ErolDude/ETF-LoRaGateway-Thesis/seal_of_approval.bmp

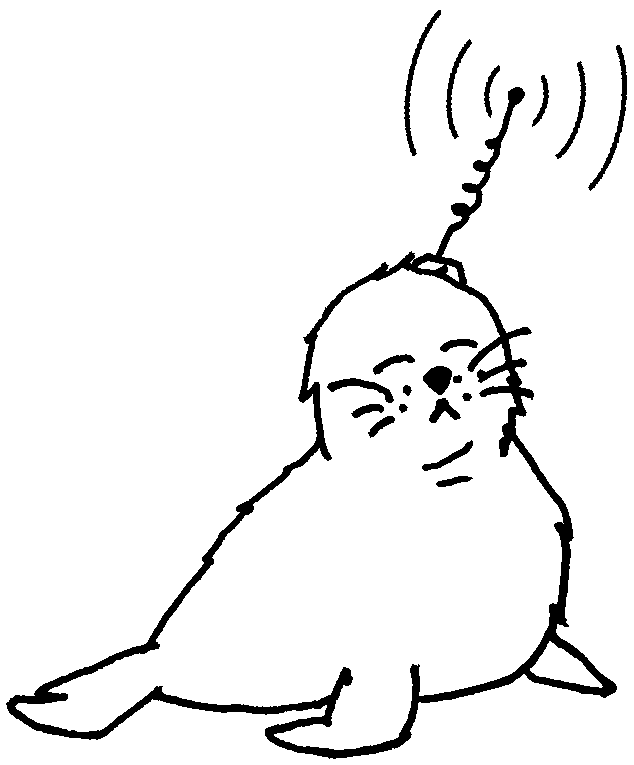
seal_of_approval.bmp
