ErolDude/ETF-LoRaGateway-Thesis/LoRa Gateway ESP32 - Final.brd

## EAGLE design LoRa Gateway ESP32 - Final.brd (2021-06-04)

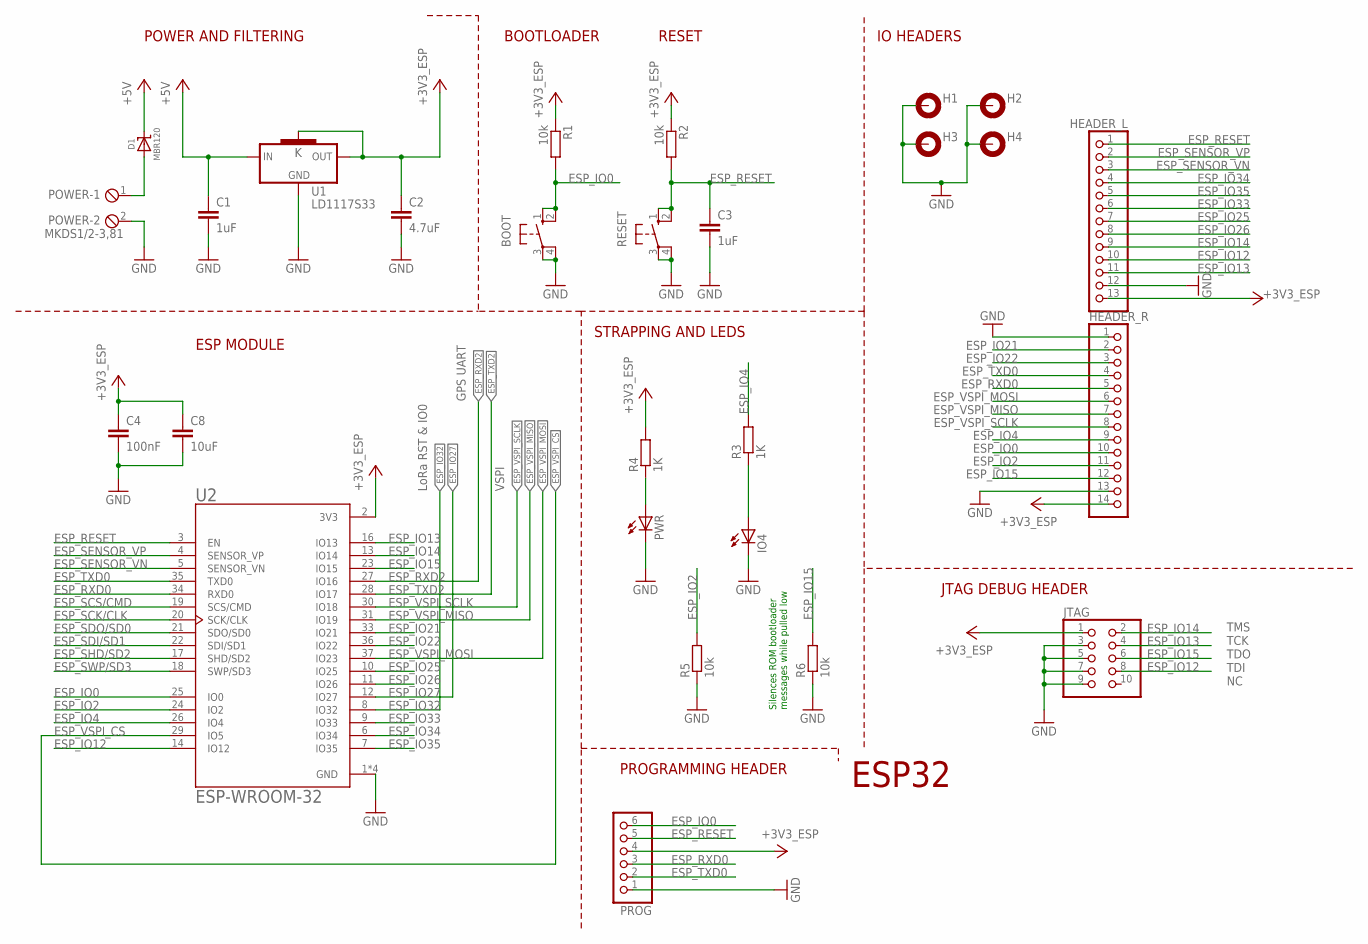
[picture p24: schematic LoRa Gateway ESP32 - Final.sch, sheet 1, ESP]

Parts:
BOOT: 10-XX; B3F-10XX
C1, C3: 1uF; C0805K
C2: 4.7uF; C0805K
C4: 100nF; C0805K
C8: 10uF; C0805K
D1: MBR120; SOD-123
H1, H2, H3, H4: MOUNT-PAD-ROUND3.2; 3,2-PAD
HEADER_L: PINHD-1X13; 1X13
HEADER_R: PINHD-1X14; 1X14
IO4: LEDCHIP-LED0805; CHIP-LED0805
JTAG: PINHD-2X5; 2X05
POWER: MKDS1/2-3,81; 2POL381
PROG: PINHD-1X6; 1X06
PWR: LEDCHIP-LED0805; CHIP-LED0805
R1, R2, R5, R6: 10k; R0805
R3, R4: 1K; R0805
RESET: 10-XX; B3F-10XX
U1: LD1117S33; SOT223
U2: ESP-WROOM-32; MODULE_ESP-WROOM-32

Connections:
+3V3_ESP: C2.1, C4.1, C8.1, HEADER_L.13, HEADER_R.14, JTAG.1, PROG.4, R1.1, R2.1, R4.2, U1.2 (OUT), U1.4 (K), U2.2 (3V3); also elsewhere on the board
+5V: C1.1, D1.C, U1.3 (IN)
ESP_IO0: BOOT.1 (S), BOOT.2 (S1), HEADER_R.10, PROG.6, R1.2, U2.25 (IO0)
ESP_IO2: HEADER_R.11, R5.2, U2.24 (IO2)
ESP_IO4: HEADER_R.9, R3.2, U2.26 (IO4)
ESP_IO12: HEADER_L.10, JTAG.8, U2.14 (IO12)
ESP_IO13: HEADER_L.11, JTAG.4, U2.16 (IO13)
ESP_IO14: HEADER_L.9, JTAG.2, U2.13 (IO14)
ESP_IO15: HEADER_R.12, JTAG.6, R6.2, U2.23 (IO15)
ESP_IO21: HEADER_R.2, U2.33 (IO21)
ESP_IO22: HEADER_R.3, U2.36 (IO22)
ESP_IO25: HEADER_L.7, U2.10 (IO25)
ESP_IO26: HEADER_L.8, U2.11 (IO26)
ESP_IO27: U2.12 (IO27); also elsewhere on the board
ESP_IO32: U2.8 (IO32); also elsewhere on the board
ESP_IO33: HEADER_L.6, U2.9 (IO33)
ESP_IO34: HEADER_L.4, U2.6 (IO34)
ESP_IO35: HEADER_L.5, U2.7 (IO35)
ESP_RESET: C3.1, HEADER_L.1, PROG.5, R2.2, RESET.1 (S), RESET.2 (S1), U2.3 (EN)
ESP_RXD0: HEADER_R.5, PROG.3, U2.34 (RXD0)
ESP_RXD2: U2.27 (IO16); also elsewhere on the board
ESP_SCK/CLK: U2.20 (SCK/CLK)
ESP_SCS/CMD: U2.19 (SCS/CMD)
ESP_SDI/SD1: U2.22 (SDI/SD1)
ESP_SDO/SD0: U2.21 (SDO/SD0)
ESP_SENSOR_VN: HEADER_L.3, U2.5 (SENSOR_VN)
ESP_SENSOR_VP: HEADER_L.2, U2.4 (SENSOR_VP)
ESP_SHD/SD2: U2.17 (SHD/SD2)
ESP_SWP/SD3: U2.18 (SWP/SD3)
ESP_TXD0: HEADER_R.4, PROG.2, U2.35 (TXD0)
ESP_TXD2: U2.28 (IO17); also elsewhere on the board
ESP_VSPI_CS: U2.29 (IO5); also elsewhere on the board
ESP_VSPI_MISO: HEADER_R.7, U2.31 (IO19); also elsewhere on the board
ESP_VSPI_MOSI: HEADER_R.6, U2.37 (IO23); also elsewhere on the board
ESP_VSPI_SCLK: HEADER_R.8, U2.30 (IO18); also elsewhere on the board
GND: BOOT.3, BOOT.4 (P1), C1.2, C2.2, C3.2, C4.2, C8.2, H1.B3,2, H2.B3,2, H3.B3,2, H4.B3,2, HEADER_L.12, HEADER_R.1, HEADER_R.13, IO4.C, JTAG.3, JTAG.5, JTAG.7, JTAG.9, POWER.2, PROG.1, PWR.C, R5.1, R6.1, RESET.3, RESET.4 (P1), U1.1 (GND), U2.1 (GND), U2.1.1 (GND), U2.15 (GND), U2.38 (GND); also elsewhere on the board
unnamed: D1.A, POWER.1
unnamed: IO4.A, R3.1
unnamed: PWR.A, R4.1

Notes on the sheet:
Silences ROM bootloader messages while pulled low
GPS UART
VSPI
LoRa RST & IO0
ESP32
JTAG DEBUG HEADER
IO HEADERS
STRAPPING AND LEDS
ESP MODULE
POWER AND FILTERING
BOOTLOADER
RESET
PROGRAMMING HEADER
TMS TCK TDO TDI NC

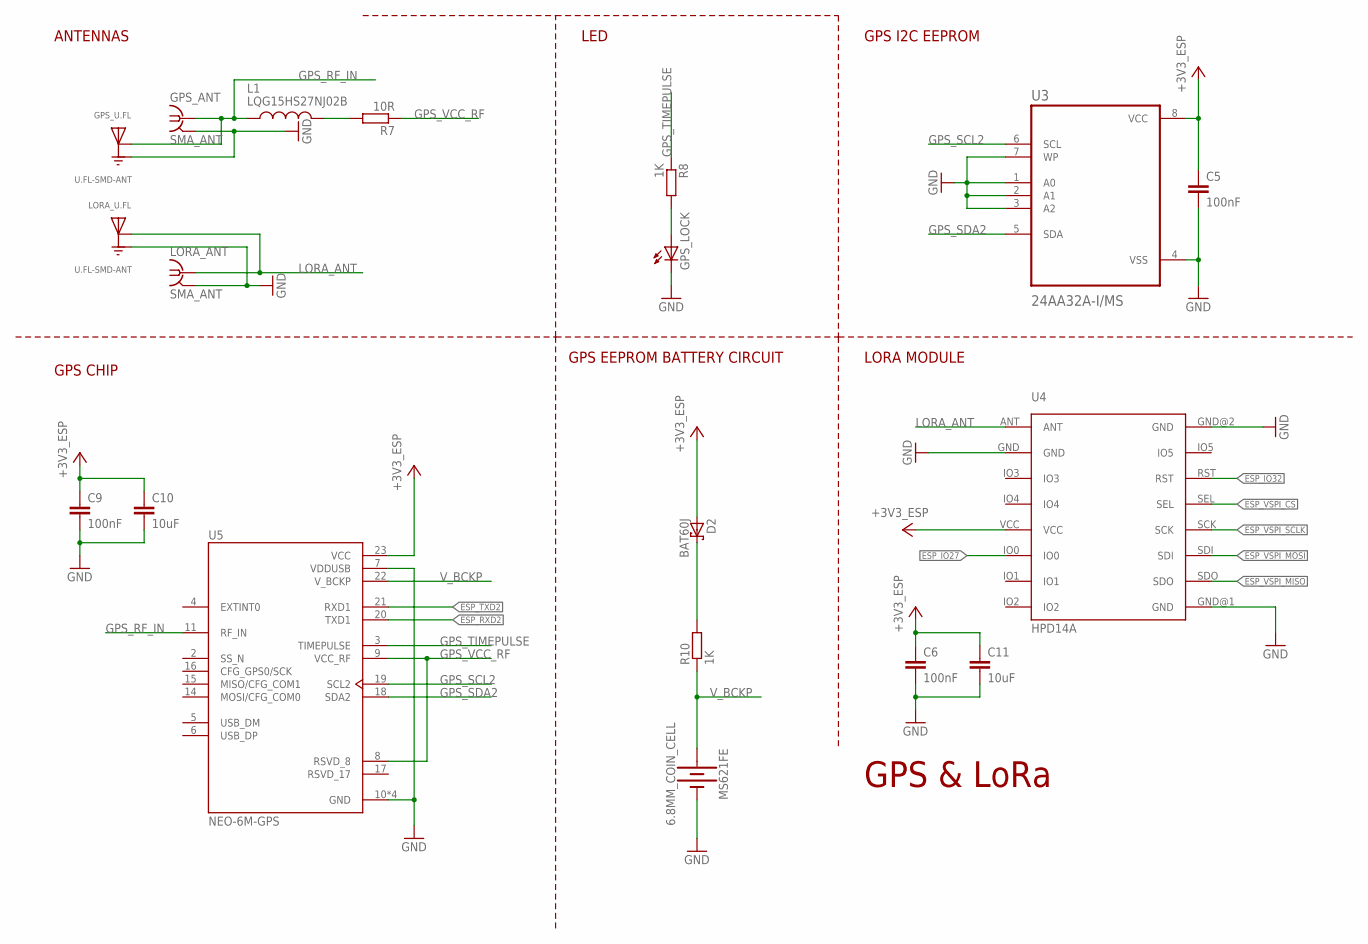
[picture p25: schematic LoRa Gateway ESP32 - Final.sch, sheet 2, Lora and GPS]

Parts:
C5, C6, C9: 100nF; C0805K
C10, C11: 10uF; C0805K
D2: BAT60J; SOD323_ST
GPS_ANT: SMA_ANT; BU-SMA-H
GPS_LOCK: LEDCHIP-LED0805; CHIP-LED0805
GPS_U.FL: U.FL-SMD-ANT; HRS_U.FL-R-SMT-1(10)
L1: LQG15HS27NJ02B; INDC1005X55N
LORA_ANT: SMA_ANT; BU-SMA-H
LORA_U.FL: U.FL-SMD-ANT; HRS_U.FL-R-SMT-1(10)
MS621FE: 6.8MM_COIN_CELL; BATTCON-6.8MM
R7: 10R; R0805
R8, R10: 1K; R0805
U3: 24AA32A-I/MS; SOP65P490X110-8N
U4: HPD14A
U5: NEO-6M-GPS; XCVR_NEO-6M-GPS

Connections:
+3V3_ESP: C5.1, C6.1, C9.1, C10.1, C11.1, D2.A, U3.8 (VCC), U4.VCC, U5.23 (VCC); also elsewhere on the board
ESP_IO27: U4.IO0; also elsewhere on the board
ESP_IO32: U4.RST; also elsewhere on the board
ESP_RXD2: U5.20 (TXD1); also elsewhere on the board
ESP_TXD2: U5.21 (RXD1); also elsewhere on the board
ESP_VSPI_CS: U4.SEL; also elsewhere on the board
ESP_VSPI_MISO: U4.SDO; also elsewhere on the board
ESP_VSPI_MOSI: U4.SDI; also elsewhere on the board
ESP_VSPI_SCLK: U4.SCK; also elsewhere on the board
GND: C5.2, C6.2, C9.2, C10.2, C11.2, GPS_ANT.2, GPS_ANT.3 (2), GPS_ANT.4 (2), GPS_ANT.5 (2), GPS_LOCK.C, GPS_U.FL.1 (GND), GPS_U.FL.3 (GND), LORA_ANT.2, LORA_ANT.3 (2), LORA_ANT.4 (2), LORA_ANT.5 (2), LORA_U.FL.1 (GND), LORA_U.FL.3 (GND), MS621FE.-, U3.1 (A0), U3.2 (A1), U3.3 (A2), U3.4 (VSS), U3.7 (WP), U4.GND, U4.GND@1 (GND), U4.GND@2 (GND), U5.7 (VDDUSB), U5.10 (GND), U5.12 (GND), U5.13 (GND), U5.24 (GND); also elsewhere on the board
GPS_RF_IN: GPS_ANT.1, GPS_U.FL.2 (SIG), L1.1, U5.11 (RF_IN)
GPS_SCL2: U3.6 (SCL), U5.19 (SCL2)
GPS_SDA2: U3.5 (SDA), U5.18 (SDA2)
GPS_TIMEPULSE: R8.1, U5.3 (TIMEPULSE)
GPS_VCC_RF: R7.1, U5.8 (RSVD_8), U5.9 (VCC_RF)
LORA_ANT: LORA_ANT.1, LORA_U.FL.2 (SIG), U4.ANT
unnamed: GPS_LOCK.A, R8.2
unnamed: L1.2, R7.2
unnamed: D2.C, R10.2
V_BCKP: MS621FE.+, R10.1, U5.22 (V_BCKP)

Notes on the sheet:
GPS & LoRa
GPS CHIP
LORA MODULE
GPS EEPROM BATTERY CIRCUIT
ANTENNAS
LED
GPS I2C EEPROM

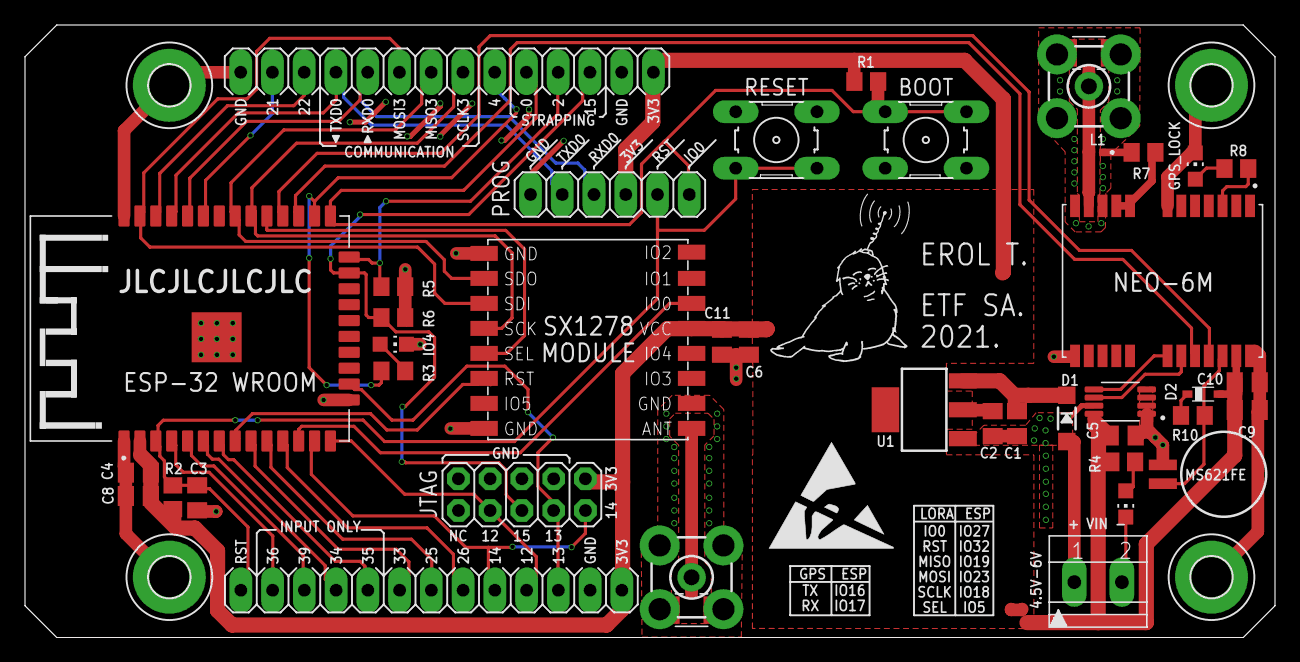
[picture p26: board LoRa Gateway ESP32 - Final.brd from above]

Board: 2 copper layers, 100.0 x 49.0 mm, 47 parts (0 on the bottom side), 43 nets.

Other parts of the board:
U$1: ESD_10.00
