ErolDude/ETF-LoRaGateway-Thesis/(commit log)

2021-06-04 Production update
    Added production variant of board and schematic. Also added gerber files used to order board
    [LoRa Gateway ESP32 - Final.brd, LoRa Gateway ESP32 - Final.sch]
2021-07-16 Final version update for written material
